denjos007/kicad-user-library/3dmodels/AI_DC-DC-Voltage-Regulators.3dshales/TSOT-23_S6_LIT-M.step

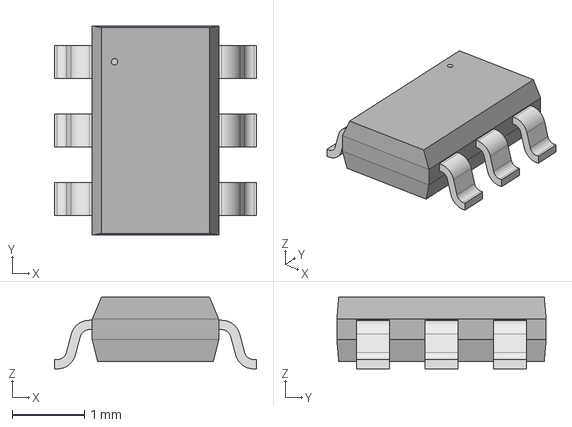
[picture p1: CAD file, 2021-03-11]
3dmodels/AI_DC-DC-Voltage-Regulators.3dshales/TSOT-23_S6_LIT-M.step
2.79 x 2.90 x 0.993 mm
