denjos007/kicad-user-library/(list of files, cad)

Other CAD files:
3dmodels/AI_DC-DC-Voltage-Regulators.3dshales/TSOT-23_S6_LIT.step
3dmodels/AI_DC-DC-Voltage-Regulators.3dshales/TSOT-23_S6_LIT-L.step
